c4puter/powercard/powercard.kicad_pcb

## KiCad design powercard.kicad_pcb (2016-07-15)

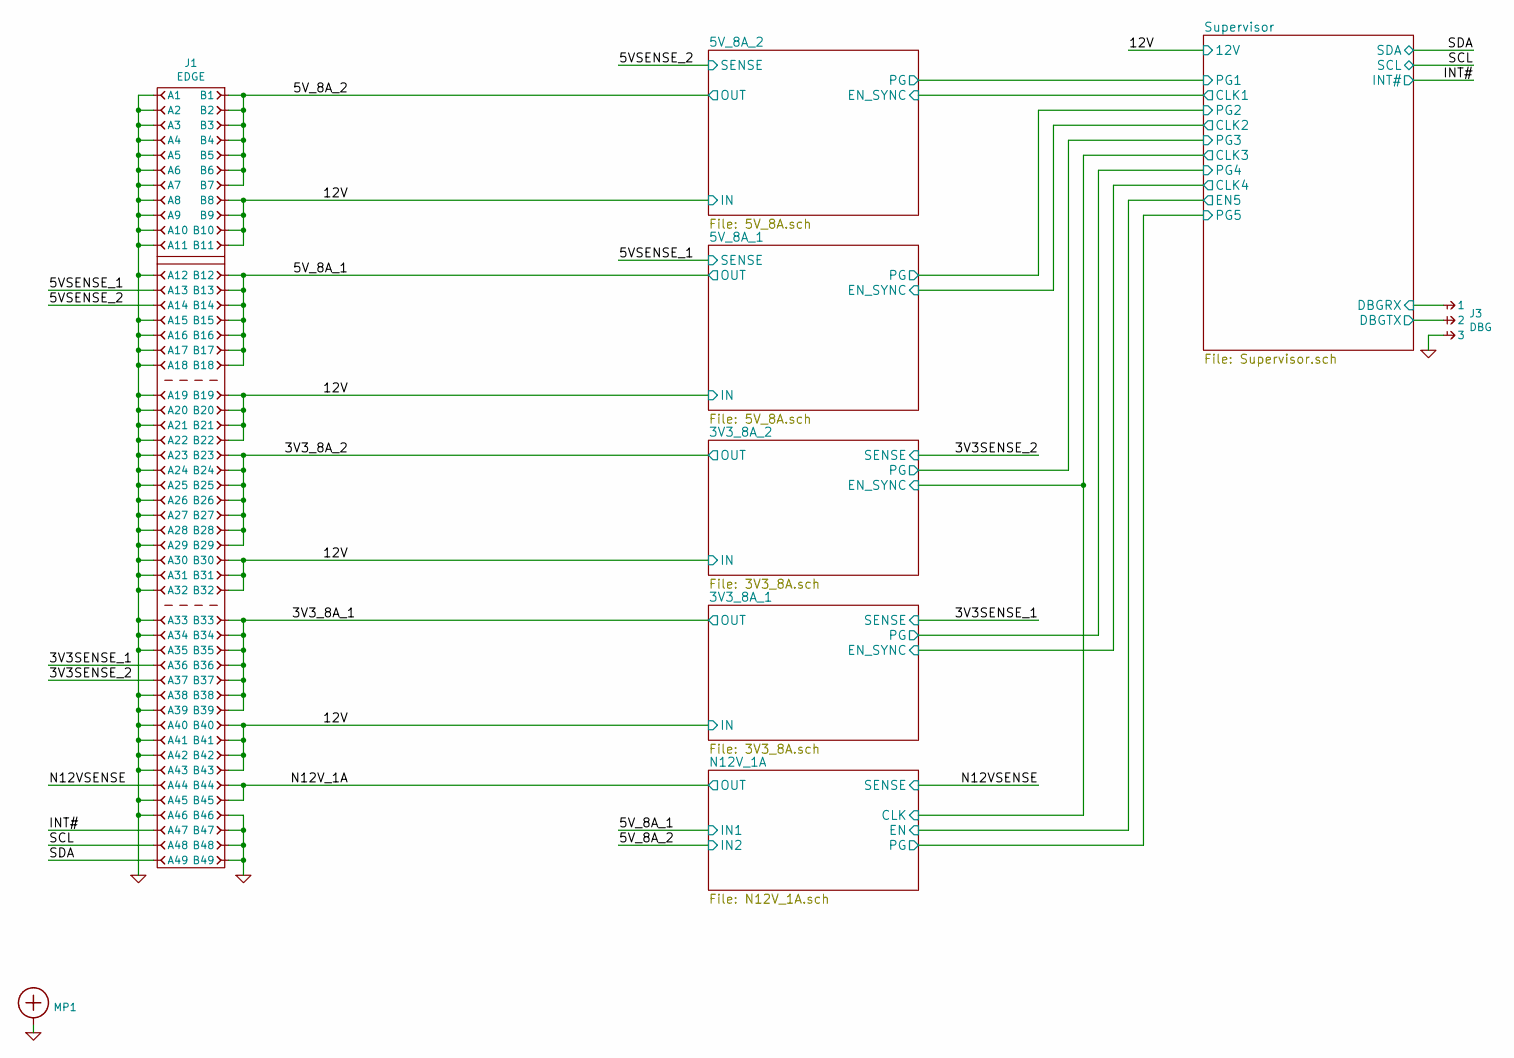
[picture p1: schematic powercard.sch, C4-0 POWER SUPPLY]

Parts:
J1: EDGE
J3: DBG; CONN-100MIL-M-1x3
MP1: SCREW; SCREW-3-SUPPORTED

Connections:
/3V3SENSE_1: J1.A36; also elsewhere on the board
/3V3SENSE_2: J1.A37; also elsewhere on the board
/3V3_8A_1: J1.B33, J1.B34, J1.B35, J1.B36, J1.B37, J1.B38, J1.B39; also elsewhere on the board
/3V3_8A_2: J1.B23, J1.B24, J1.B25, J1.B26, J1.B27, J1.B28, J1.B29; also elsewhere on the board
/5VSENSE_1: J1.A13; also elsewhere on the board
/5VSENSE_2: J1.A14; also elsewhere on the board
/5V_8A_1: J1.B12, J1.B13, J1.B14, J1.B15, J1.B16, J1.B17, J1.B18; also elsewhere on the board
/5V_8A_2: J1.B1, J1.B2, J1.B3, J1.B4, J1.B5, J1.B6, J1.B7; also elsewhere on the board
/12V: J1.B8, J1.B9, J1.B10, J1.B11, J1.B19, J1.B20, J1.B21, J1.B22, J1.B30, J1.B31, J1.B32, J1.B40, J1.B41, J1.B42, J1.B43; also elsewhere on the board
/INT#: J1.A47; also elsewhere on the board
/N12VSENSE: J1.A44; also elsewhere on the board
/N12V_1A: J1.B44, J1.B45; also elsewhere on the board
/SCL: J1.A48; also elsewhere on the board
/SDA: J1.A49; also elsewhere on the board
/Supervisor/DBGRX: J3.1; also elsewhere on the board
/Supervisor/DBGTX: J3.2; also elsewhere on the board
GND: J1.A1, J1.A2, J1.A3, J1.A4, J1.A5, J1.A6, J1.A7, J1.A8, J1.A9, J1.A10, J1.A11, J1.A12, J1.A15, J1.A16, J1.A17, J1.A18, J1.A19, J1.A20, J1.A21, J1.A22, J1.A23, J1.A24, J1.A25, J1.A26, J1.A27, J1.A28, J1.A29, J1.A30, J1.A31, J1.A32, J1.A33, J1.A34, J1.A35, J1.A38, J1.A39, J1.A40, J1.A41, J1.A42, J1.A43, J1.A45, J1.A46, J1.B46, J1.B47, J1.B48, J1.B49, J3.3, MP1.1; also elsewhere on the board

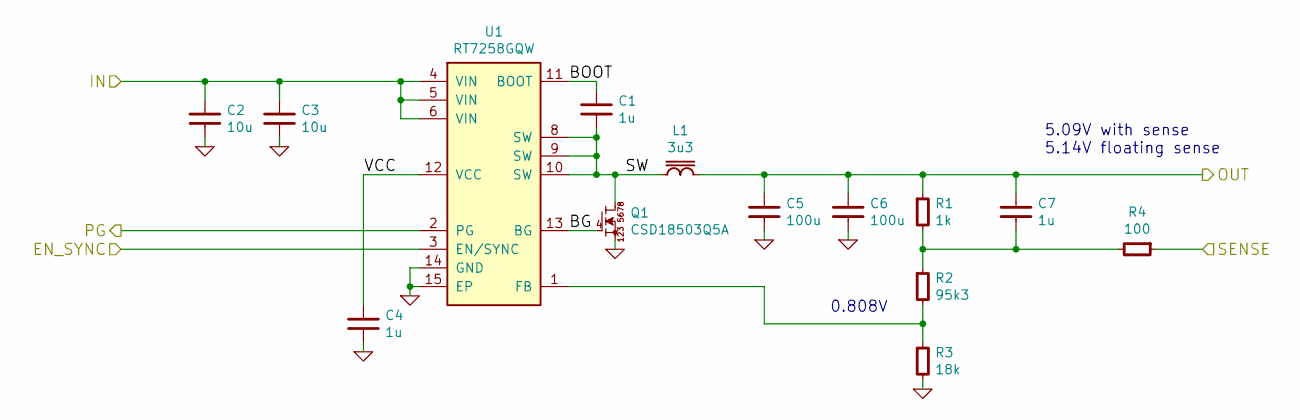
[picture p2: schematic 5V_8A.sch, 5V 8A regulator block]

Parts:
C8, C9: 10u; CAPC2012X70
C10, C11, C14: 1u; CAPC1608X55
C12, C13: 100u; CAPC3225X88
L2: 3u3; BOURNS-SRP1238A
Q2: CSD18503Q5A; TEXAS-Q5A
R5: 1k; RESC1608X50
R6: 95k3; RESC1608X50
R7: 18k; RESC1608X50
R8: 100; RESC1608X50
U2: RT7258GQW; DFN50P300X400X80-15

Connections:
/5VSENSE_1: R8.1; also elsewhere on the board
/5V_8A_1: C12.1, C13.1, C14.1, L2.1, R5.1; also elsewhere on the board
/5V_8A_1/BG: Q2.4 (G), U2.13 (BG)
/5V_8A_1/BOOT: C11.1, U2.11 (BOOT)
/5V_8A_1/PG: U2.2 (PG); also elsewhere on the board
/5V_8A_1/SW: C11.2, L2.2, Q2.5 (D), Q2.6 (D), Q2.7 (D), Q2.8 (D), U2.8 (SW), U2.9 (SW), U2.10 (SW)
/5V_8A_1/VCC: C10.1, U2.12 (VCC)
/12V: C8.1, C9.1, U2.4 (VIN), U2.5 (VIN), U2.6 (VIN); also elsewhere on the board
/Supervisor/CLK2: U2.3 (EN/SYNC); also elsewhere on the board
GND: C8.2, C9.2, C10.2, C12.2, C13.2, Q2.1 (S), Q2.2 (S), Q2.3 (S), R7.2, U2.14 (GND), U2.15 (EP); also elsewhere on the board
unnamed: C14.2, R5.2, R6.1, R8.2
unnamed: R6.2, R7.1, U2.1 (FB)

Parts of its further copies:
C1, C4, C7: 1u; CAPC1608X55
C2, C3: 10u; CAPC2012X70
C5, C6: 100u; CAPC3225X88
L1: 3u3; BOURNS-SRP1238A
Q1: CSD18503Q5A; TEXAS-Q5A
R1: 1k; RESC1608X50
R2: 95k3; RESC1608X50
R3: 18k; RESC1608X50
R4: 100; RESC1608X50
U1: RT7258GQW; DFN50P300X400X80-15

Connections of its further copies:
/5VSENSE_2: R4.1; also elsewhere on the board
/5V_8A_2: C5.1, C6.1, C7.1, L1.1, R1.1; also elsewhere on the board
/5V_8A_2/BG: Q1.4 (G), U1.13 (BG)
/5V_8A_2/BOOT: C1.1, U1.11 (BOOT)
/5V_8A_2/PG: U1.2 (PG); also elsewhere on the board
/5V_8A_2/SW: C1.2, L1.2, Q1.5 (D), Q1.6 (D), Q1.7 (D), Q1.8 (D), U1.8 (SW), U1.9 (SW), U1.10 (SW)
/5V_8A_2/VCC: C4.1, U1.12 (VCC)
/12V: C2.1, C3.1, U1.4 (VIN), U1.5 (VIN), U1.6 (VIN); also elsewhere on the board
/Supervisor/CLK1: U1.3 (EN/SYNC); also elsewhere on the board
GND: C2.2, C3.2, C4.2, C5.2, C6.2, Q1.1 (S), Q1.2 (S), Q1.3 (S), R3.2, U1.14 (GND), U1.15 (EP); also elsewhere on the board
unnamed: C7.2, R1.2, R2.1, R4.2
unnamed: R2.2, R3.1, U1.1 (FB)

Notes on the sheet:
0.808V
5.09V with sense 5.14V floating sense

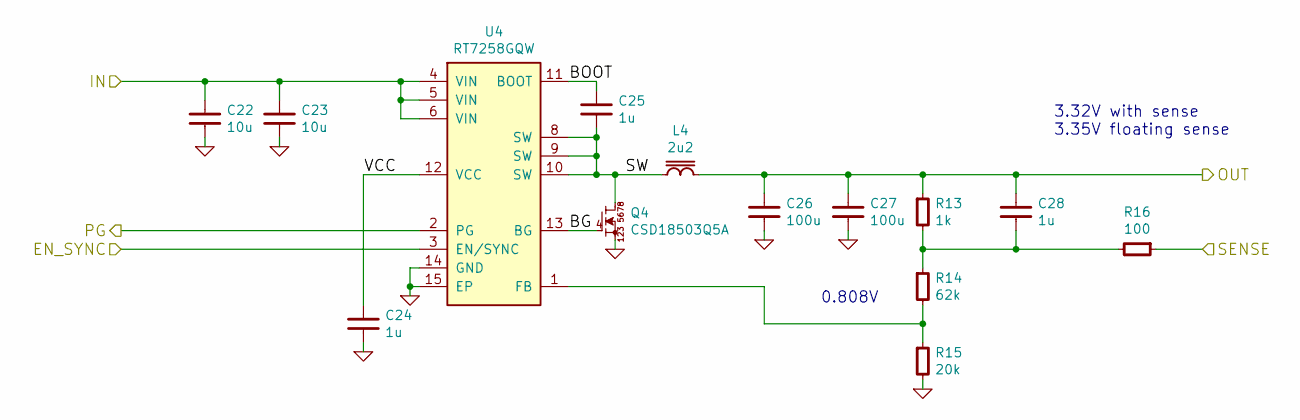
[picture p3: schematic 3V3_8A.sch, 3V3 8A regulator block]

Parts:
C15, C16: 10u; CAPC2012X70
C17, C18, C21: 1u; CAPC1608X55
C19, C20: 100u; CAPC3225X88
L3: 2u2; BOURNS-SRP1238A
Q3: CSD18503Q5A; TEXAS-Q5A
R9: 1k; RESC1608X50
R10: 62k; RESC1608X50
R11: 20k; RESC1608X50
R12: 100; RESC1608X50
U3: RT7258GQW; DFN50P300X400X80-15

Connections:
/3V3SENSE_1: R12.1; also elsewhere on the board
/3V3_8A_1: C19.1, C20.1, C21.1, L3.1, R9.1; also elsewhere on the board
/3V3_8A_1/BG: Q3.4 (G), U3.13 (BG)
/3V3_8A_1/BOOT: C18.1, U3.11 (BOOT)
/3V3_8A_1/PG: U3.2 (PG); also elsewhere on the board
/3V3_8A_1/SW: C18.2, L3.2, Q3.5 (D), Q3.6 (D), Q3.7 (D), Q3.8 (D), U3.8 (SW), U3.9 (SW), U3.10 (SW)
/3V3_8A_1/VCC: C17.1, U3.12 (VCC)
/12V: C15.1, C16.1, U3.4 (VIN), U3.5 (VIN), U3.6 (VIN); also elsewhere on the board
/Supervisor/CLK4: U3.3 (EN/SYNC); also elsewhere on the board
GND: C15.2, C16.2, C17.2, C19.2, C20.2, Q3.1 (S), Q3.2 (S), Q3.3 (S), R11.2, U3.14 (GND), U3.15 (EP); also elsewhere on the board
unnamed: C21.2, R9.2, R10.1, R12.2
unnamed: R10.2, R11.1, U3.1 (FB)

Parts of its further copies:
C22, C23: 10u; CAPC2012X70
C24, C25, C28: 1u; CAPC1608X55
C26, C27: 100u; CAPC3225X88
L4: 2u2; BOURNS-SRP1238A
Q4: CSD18503Q5A; TEXAS-Q5A
R13: 1k; RESC1608X50
R14: 62k; RESC1608X50
R15: 20k; RESC1608X50
R16: 100; RESC1608X50
U4: RT7258GQW; DFN50P300X400X80-15

Connections of its further copies:
/3V3SENSE_2: R16.1; also elsewhere on the board
/3V3_8A_2: C26.1, C27.1, C28.1, L4.1, R13.1; also elsewhere on the board
/3V3_8A_2/BG: Q4.4 (G), U4.13 (BG)
/3V3_8A_2/BOOT: C25.1, U4.11 (BOOT)
/3V3_8A_2/PG: U4.2 (PG); also elsewhere on the board
/3V3_8A_2/SW: C25.2, L4.2, Q4.5 (D), Q4.6 (D), Q4.7 (D), Q4.8 (D), U4.8 (SW), U4.9 (SW), U4.10 (SW)
/3V3_8A_2/VCC: C24.1, U4.12 (VCC)
/12V: C22.1, C23.1, U4.4 (VIN), U4.5 (VIN), U4.6 (VIN); also elsewhere on the board
/N12V_1A/CLK: U4.3 (EN/SYNC); also elsewhere on the board
GND: C22.2, C23.2, C24.2, C26.2, C27.2, Q4.1 (S), Q4.2 (S), Q4.3 (S), R15.2, U4.14 (GND), U4.15 (EP); also elsewhere on the board
unnamed: C28.2, R13.2, R14.1, R16.2
unnamed: R14.2, R15.1, U4.1 (FB)

Notes on the sheet:
3.32V with sense 3.35V floating sense
0.808V

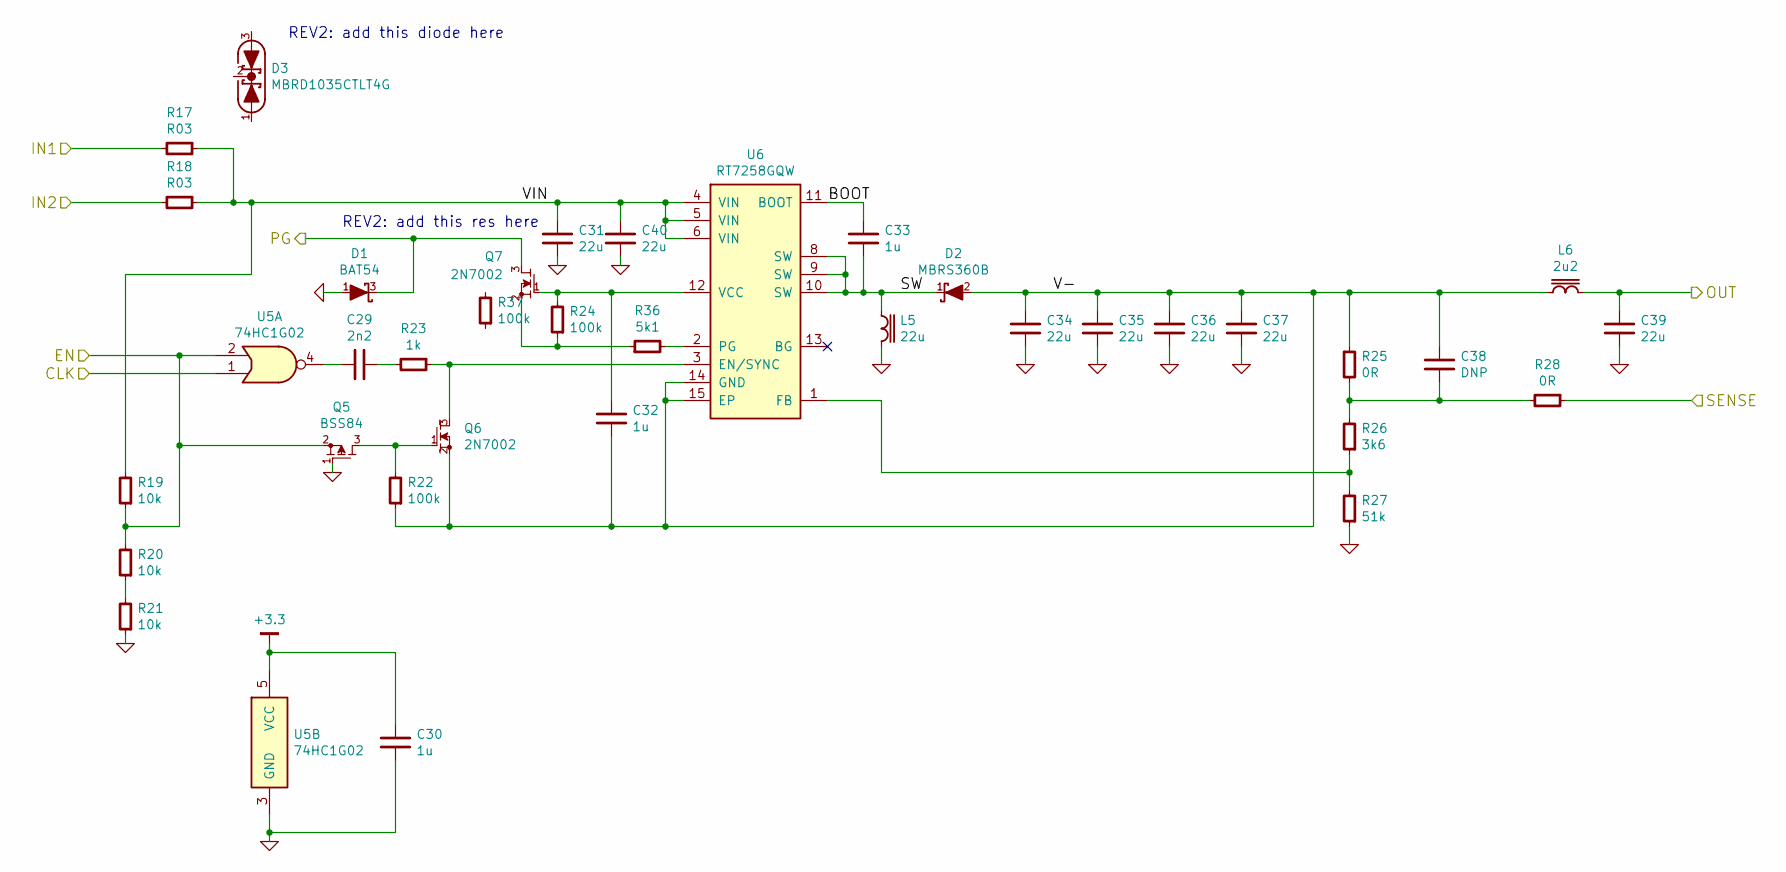
[picture p4: schematic N12V_1A.sch, -12V 1A regulator block]

Parts:
C29: 2n2; CAPC1608X55
C30, C32, C33: 1u; CAPC1608X55
C31, C34, C35, C36, C37, C39, C40: 22u; CAPC3216X70
C38: DNP; CAPC1608X55
D1: BAT54; SOT-23
D2: MBRS360B; DIOM5436X244
D3: MBRD1035CTLT4G
L5: 22u; BOURNS-SRR1210
L6: 2u2; INDC2520X220
Q5: BSS84; SOT-23
Q6, Q7: 2N7002; SOT-23
R17, R18: R03; RESC2012X50
R19, R20, R21: 10k; RESC1608X50
R22, R24, R37: 100k; RESC1608X50
R23: 1k; RESC1608X50
R25, R28: 0R; RESC1608X50
R26: 3k6; RESC1608X50
R27: 51k; RESC1608X50
R36: 5k1; RESC1608X50
U5: 74HC1G02; SC-70-5
U6: RT7258GQW; DFN50P300X400X80-15

Connections:
+3.3: C30.1, U5.5 (VCC); also elsewhere on the board
/5V_8A_1: R17.2; also elsewhere on the board
/5V_8A_2: R18.2; also elsewhere on the board
/N12VSENSE: R28.1; also elsewhere on the board
/N12V_1A: C39.1, L6.1; also elsewhere on the board
/N12V_1A/BOOT: C33.1, U6.11 (BOOT)
/N12V_1A/CLK: U5.1; also elsewhere on the board
/N12V_1A/EN: Q5.2 (S), R19.1, R20.2, U5.2; also elsewhere on the board
/N12V_1A/PG: D1.3 (K), Q7.3; also elsewhere on the board
/N12V_1A/SW: C33.2, D2.1 (K), L5.2, U6.8 (SW), U6.9 (SW), U6.10 (SW)
/N12V_1A/V-: C32.2, C34.1, C35.1, C36.1, C37.1, C38.1, D2.2 (A), L6.2, Q6.2, R22.1, R25.1, U6.14 (GND), U6.15 (EP)
/N12V_1A/VIN: C31.1, C40.1, R17.1, R18.1, R19.2, U6.4 (VIN), U6.5 (VIN), U6.6 (VIN)
GND: C30.2, C31.2, C34.2, C35.2, C36.2, C37.2, C39.2, C40.2, D1.1 (A), L5.1, Q5.1 (G), R21.1, R27.1, U5.3 (GND); also elsewhere on the board
unnamed: C29.1, R23.2
unnamed: C29.2, U5.4
unnamed: C32.1, Q7.1, R24.2, U6.12 (VCC)
unnamed: C38.2, R25.2, R26.2, R28.2
unnamed: Q5.3 (D), Q6.1, R22.2
unnamed: Q6.3, R23.1, U6.3 (EN/SYNC)
unnamed: Q7.2, R24.1, R36.1
unnamed: R20.1, R21.2
unnamed: R26.1, R27.2, U6.1 (FB)
unnamed: R36.2, U6.2 (PG)

Notes on the sheet:
REV2: add this diode here
REV2: add this res here

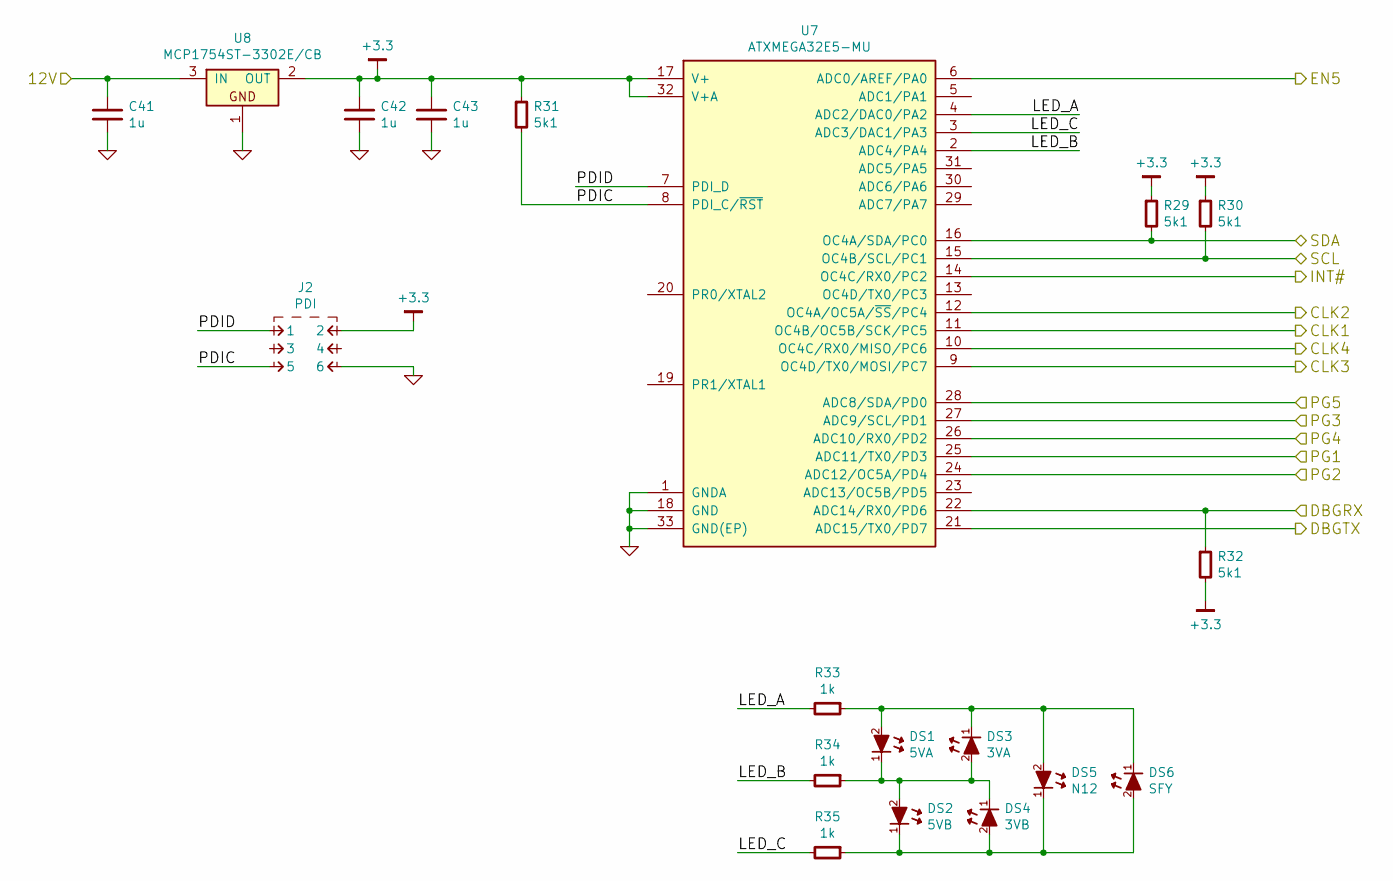
[picture p5: schematic Supervisor.sch]

Parts:
C41, C42, C43: 1u; CAPC1608X55
DS1: 5VA; LED-0603
DS2: 5VB; LED-0603
DS3: 3VA; LED-0603
DS4: 3VB; LED-0603
DS5: N12; LED-0603
DS6: SFY; LED-0603
J2: PDI; CONN-100MIL-M-2x3
R29, R30, R31, R32: 5k1; RESC1608X50
R33, R34, R35: 1k; RESC1608X50
U7: ATXMEGA32E5-MU; QFN50P500X500X100-33
U8: MCP1754ST-3302E/CB; SOT-23

Connections:
+3.3: C42.1, C43.1, J2.2, R29.1, R30.1, R31.1, R32.2, U7.17 (V+), U7.32 (V+A), U8.2 (OUT); also elsewhere on the board
/3V3_8A_1/PG: U7.26 (ADC10/RX0/PD2); also elsewhere on the board
/3V3_8A_2/PG: U7.27 (ADC9/SCL/PD1); also elsewhere on the board
/5V_8A_1/PG: U7.24 (ADC12/OC5A/PD4); also elsewhere on the board
/5V_8A_2/PG: U7.25 (ADC11/TX0/PD3); also elsewhere on the board
/12V: C41.1, U8.3 (IN); also elsewhere on the board
/INT#: U7.14 (OC4C/RX0/PC2); also elsewhere on the board
/N12V_1A/CLK: U7.9 (OC4D/TX0/MOSI/PC7); also elsewhere on the board
/N12V_1A/EN: U7.6 (ADC0/AREF/PA0); also elsewhere on the board
/N12V_1A/PG: U7.28 (ADC8/SDA/PD0); also elsewhere on the board
/SCL: R30.2, U7.15 (OC4B/SCL/PC1); also elsewhere on the board
/SDA: R29.2, U7.16 (OC4A/SDA/PC0); also elsewhere on the board
/Supervisor/CLK1: U7.11 (OC4B/OC5B/SCK/PC5); also elsewhere on the board
/Supervisor/CLK2: U7.12 (OC4A/OC5A/~SS~/PC4); also elsewhere on the board
/Supervisor/CLK4: U7.10 (OC4C/RX0/MISO/PC6); also elsewhere on the board
/Supervisor/DBGRX: R32.1, U7.22 (ADC14/RX0/PD6); also elsewhere on the board
/Supervisor/DBGTX: U7.21 (ADC15/TX0/PD7); also elsewhere on the board
/Supervisor/LED_A: R33.2, U7.4 (ADC2/DAC0/PA2)
/Supervisor/LED_B: R34.2, U7.2 (ADC4/PA4)
/Supervisor/LED_C: R35.2, U7.3 (ADC3/DAC1/PA3)
/Supervisor/PDIC: J2.5, R31.2, U7.8 (PDI_C/~RST)
/Supervisor/PDID: J2.1, U7.7 (PDI_D)
GND: C41.2, C42.2, C43.2, J2.6, U7.1 (GNDA), U7.18 (GND), U7.33 (GND(EP)), U8.1 (GND); also elsewhere on the board
unnamed: DS1.1 (K), DS2.2 (A), DS3.2 (A), DS4.1 (K), R34.1
unnamed: DS1.2 (A), DS3.1 (K), DS5.2 (A), DS6.1 (K), R33.1
unnamed: DS2.1 (K), DS4.2 (A), DS5.1 (K), DS6.2 (A), R35.1

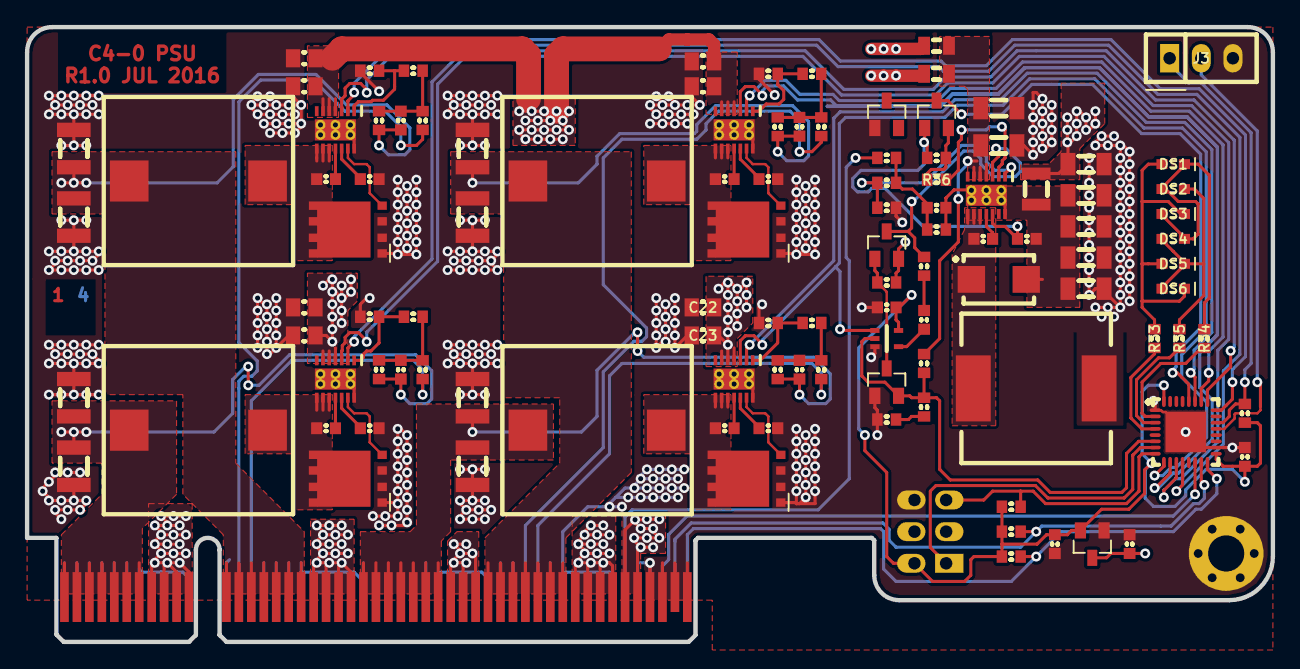
[picture p6: board powercard.kicad_pcb from above]

Board: 4 copper layers, 100.0 x 49.4 mm, 112 parts (0 on the bottom side), 74 nets.
