c4puter/powercard/(commit log)

2016-07-01 Layout tweaks
    [powercard.kicad_pcb, powercard.sch]
2016-07-01 More PCB tweaks
    [3V3_8A.sch, 5V_8A.sch, N12V_1A.sch, Supervisor.sch, powercard.kicad_pcb, powercard.sch]
2016-07-02 Even more PCB tweaks
    [powercard.kicad_pcb]
2016-07-03 Commit R1.0 sent to fab
    [3V3_8A.sch, 5V_8A.sch, N12V_1A.sch, Supervisor.sch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]
2016-07-15 Final rev take 2
    [3V3_8A.sch, N12V_1A.sch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]
